LuisYonOfficial/Universal-Timing-Check-Device/Hardware/README.md

# Universal Timing Check Board (UTCB)
###### This repo acts as the digital storage of all associated developments (e.g. firmware, pcb development, CAD) and related documentation (e.g. schematic captures, pictures, testing data) to the "Universal Timing Check Board". This device acts as a sister companion to circuit testing for analog voltage checks and timing. Inspiration for board function and design is from previous revisions of an analog based brake system plausiblity device, however, this device is more general purpose and for my personal use. 

Image below shows a general esimate of how I intended the board to look like and inspired by (although to be at a much much smaller dimensional board footprint)



## Board Functionality
- Check if an upper threshold is met. (0v to 12v)
    - Multichannel Comparator check
- Check if a lower threshold is met.
    - Multichannel Comparator check (0v to 12v)
- Check if mid threshold comparison between 6 signals is met. 
    - Mid-threshold voltage set via 6 potentiometers (0v to 12v)
- Drive a failure mode signal out from either signals (12v, 7.5v, 3.3v, 0v)
- Have RGB LEDs that glow based on what failure condition per signal is failed or if there’s a net pass. These are tied to comparators? Might be tricky. 
    - Red: Threshold failure
    - Orange: Timing Failure
    - Green: No Failure
- Has breakout OLED slot for visualizing data in real time with bluetooth connected transmitter. Most likely will use STM32 for MCU. 
    
## Board Connection Points

Main PWR: 
- Optional 12V Power In Connector (Expands to 12v and 7.5v option for logic) 
- Main 5V Power In connector (Sets 5v and 3.3c logic)
- Final PWR voltage needs to be regulated (Off the shelf chip) 

Signal Connections (For reading)
- Terminal block connection points (4P header) for direct wire feeds. 
- For signal voltage reading: Has ribbon cable attachment to breadboard for data collection (but no direct programmable element on-board). 
- For board debugging: Set test points to grip onto for PWR points, Comparator Outputs, and final failure outputs. 
- Indivdual signals, logic set positions, threshold voltages are passed through to the data collection slot for telemetry. 

## Purpose

- Allows me to isolate analog logic voltages on an offboard device or PCB. 
- Allows me to clearly indicate where faulty logic is based on physical tuning via potentiometers. 
- Gives me an automated way of doing logic checks over set number of iterations on the device under test. 

## What to do next
- Finish basic logic check circuitry for 6 signals.
- Need to find a comparator chipset rated for 12v and higher. 
- Develop basic logic switch circuitry for determining if 3.3v, 5v, 7.5v, or 12v is being utilized for logic.
