LuisYonOfficial/Universal-Timing-Check-Device/Hardware/AddedFootprints/3D_Only/song-huei-r0904n-bxxx-l-20kq-by-thonk-1.snapshot.9/Thonk.jpg

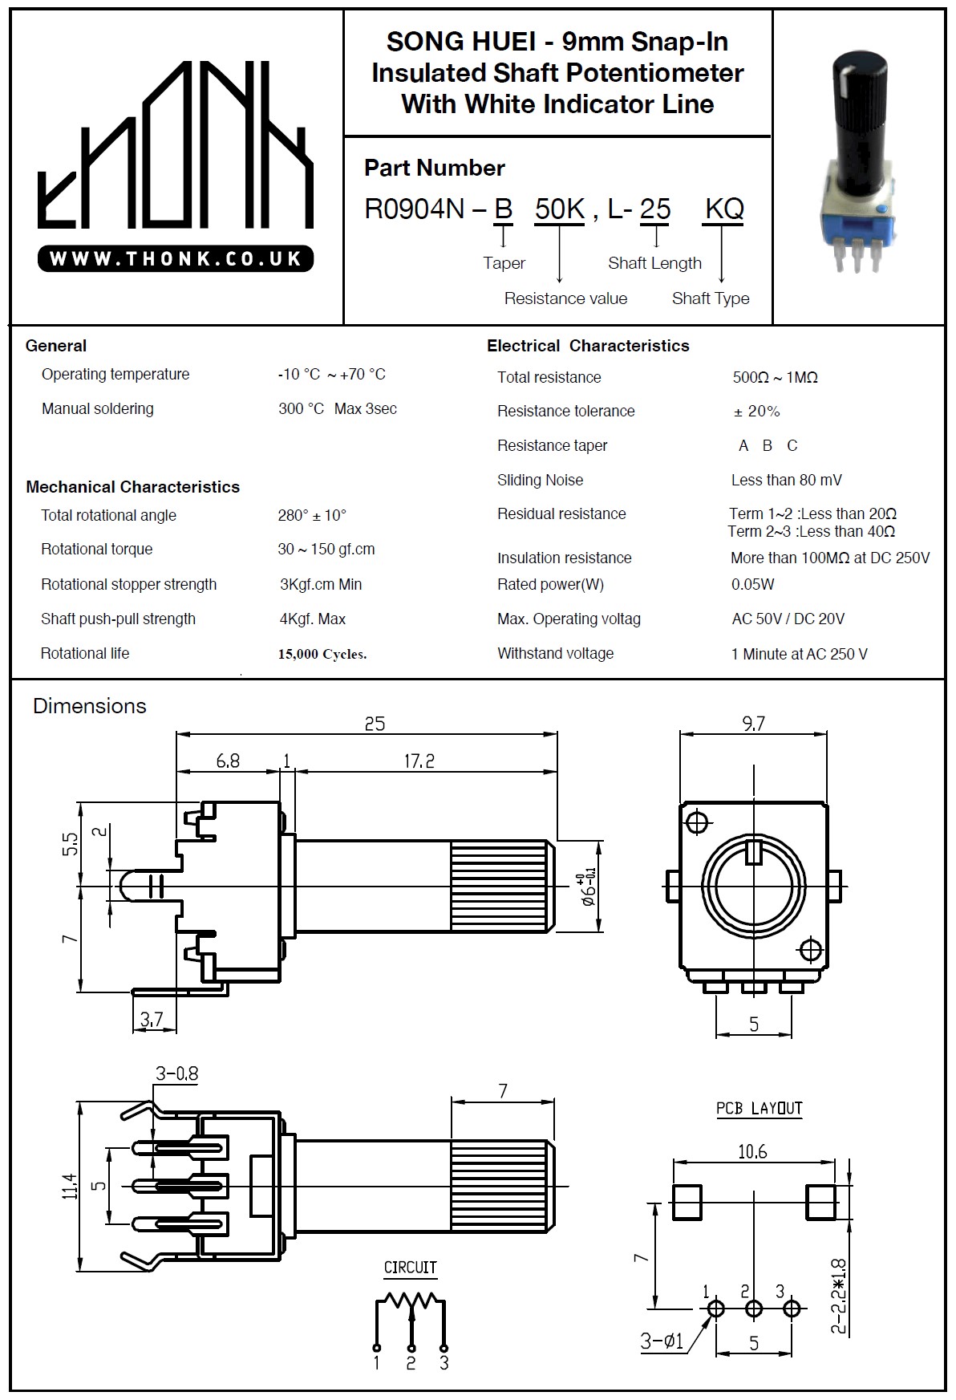
Hardware/AddedFootprints/3D_Only/song-huei-r0904n-bxxx-l-20kq-by-thonk-1.snapshot.9/Thonk.jpg
