LuisYonOfficial/Universal-Timing-Check-Device/Hardware/AddedFootprints/3D_Only/song-huei-r0904n-bxxx-l-20kq-by-thonk-1.snapshot.9/stp/R0904N-L-20KQ.stp

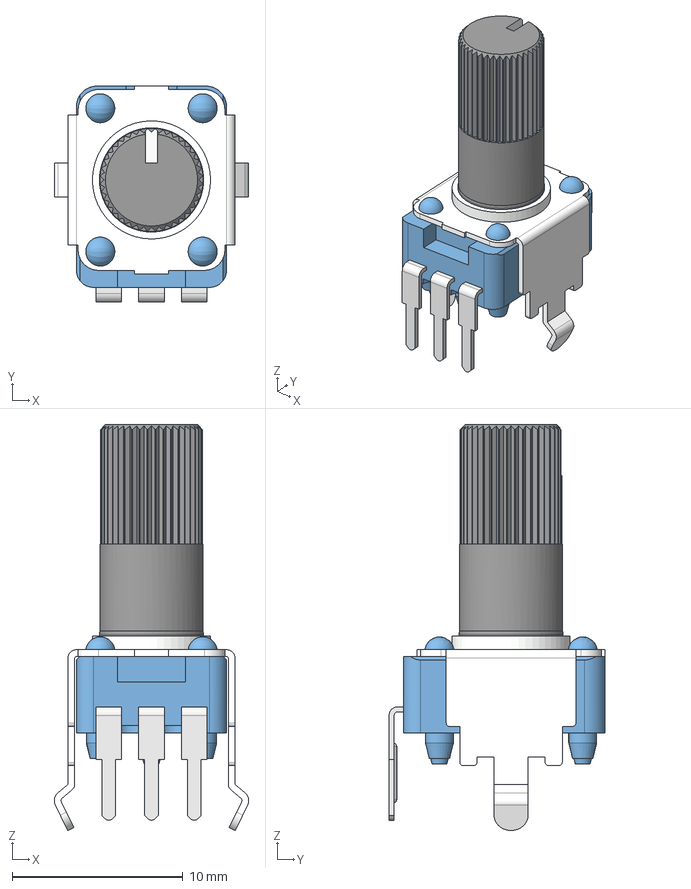
[picture p4: CAD file, 2023-03-07]
Hardware/AddedFootprints/3D_Only/song-huei-r0904n-bxxx-l-20kq-by-thonk-1.snapshot.9/stp/R0904N-L-20KQ.stp
11.4 x 12.7 x 23.8 mm
