LuisYonOfficial/Universal-Timing-Check-Device/Hardware/AddedFootprints/LIB_2SB1707TL/2SB1707TL/3D/2SB1707TL.stp

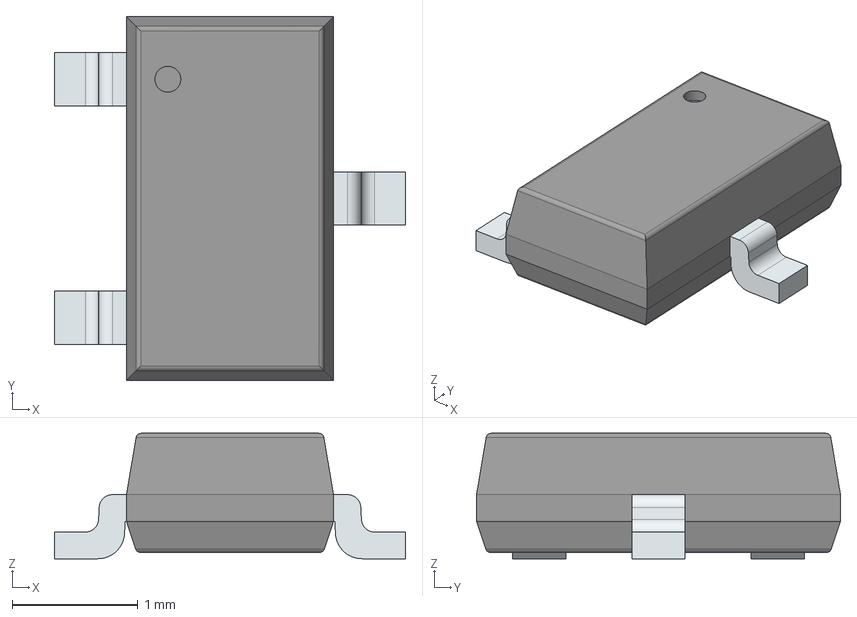
[picture p6: CAD file, 2023-03-03]
Hardware/AddedFootprints/LIB_2SB1707TL/2SB1707TL/3D/2SB1707TL.stp
2.80 x 2.90 x 1.00 mm
PinsArrayL
FilletPinR
