LuisYonOfficial/Universal-Timing-Check-Device/Hardware/AddedFootprints/LIB_2SD2653KT146/2SD2653KT146/3D/2SD2653KT146.stp

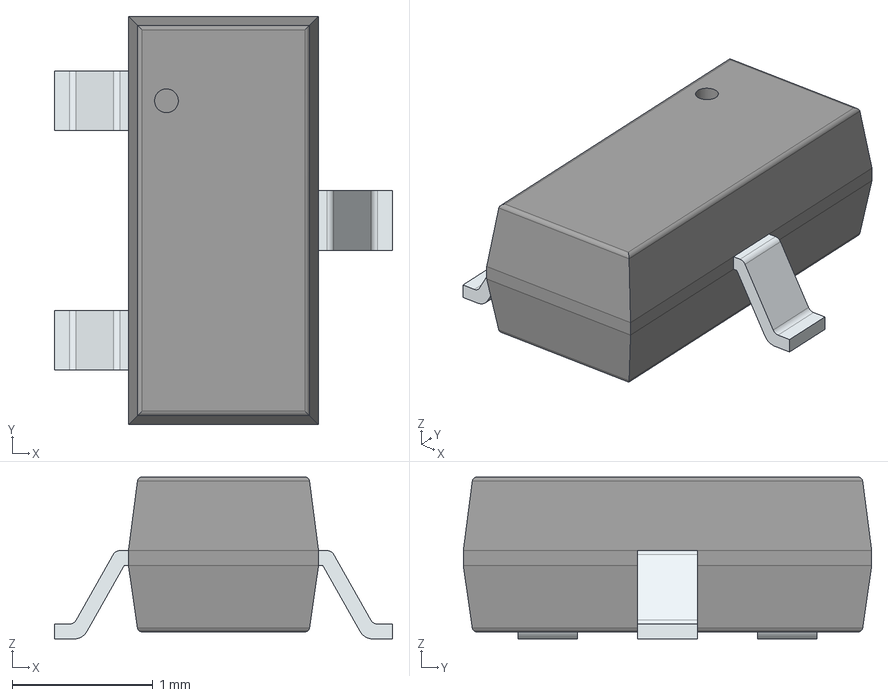
[picture p7: CAD file, 2023-03-03]
Hardware/AddedFootprints/LIB_2SD2653KT146/2SD2653KT146/3D/2SD2653KT146.stp
2.40 x 2.90 x 1.15 mm
PinsArrayL
FilletPinR
