LuisYonOfficial/Universal-Timing-Check-Device/Hardware/AddedFootprints/LIB_3557-2/3557-2/3D/3557-2.stp

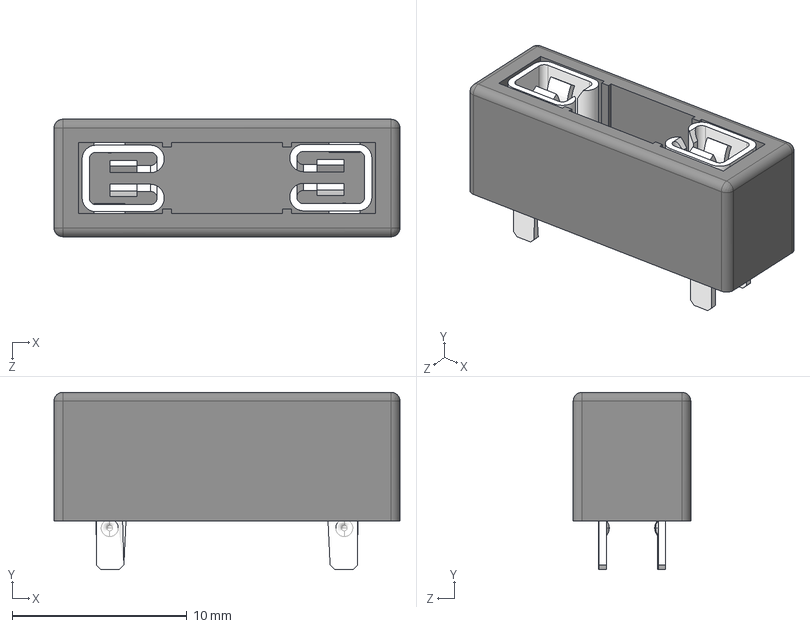
[picture p8: CAD file, 2023-03-03]
Hardware/AddedFootprints/LIB_3557-2/3557-2/3D/3557-2.stp
19.8 x 10.2 x 6.73 mm
