LuisYonOfficial/Universal-Timing-Check-Device/Hardware/AddedFootprints/LIB_BZT52H-A3V3-QX/BZT52H-A3V3-QX/3D/BZT52H-A3V3-QX.stp

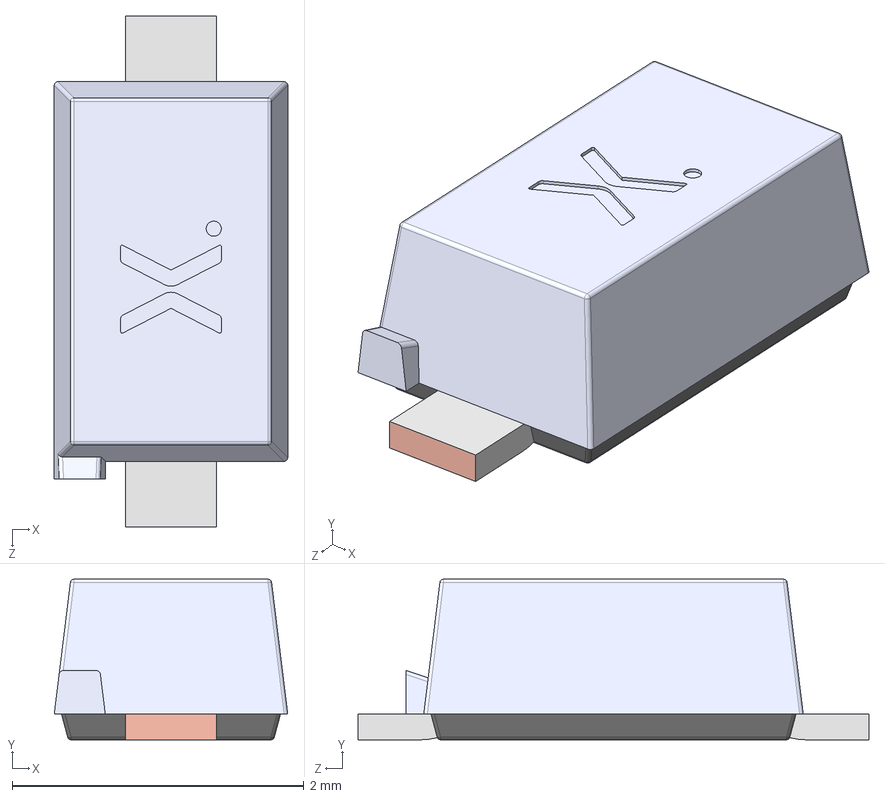
[picture p9: CAD file, 2023-03-03]
Hardware/AddedFootprints/LIB_BZT52H-A3V3-QX/BZT52H-A3V3-QX/3D/BZT52H-A3V3-QX.stp
1.60 x 1.10 x 3.50 mm
SOD123F Lead
SOD123F lower body
SOD123F upper body
