LuisYonOfficial/Universal-Timing-Check-Device/Hardware/AddedFootprints/LIB_MM3Z12VT1GX/MM3Z12VT1GX/3D/MM3Z12VT1GX.stp

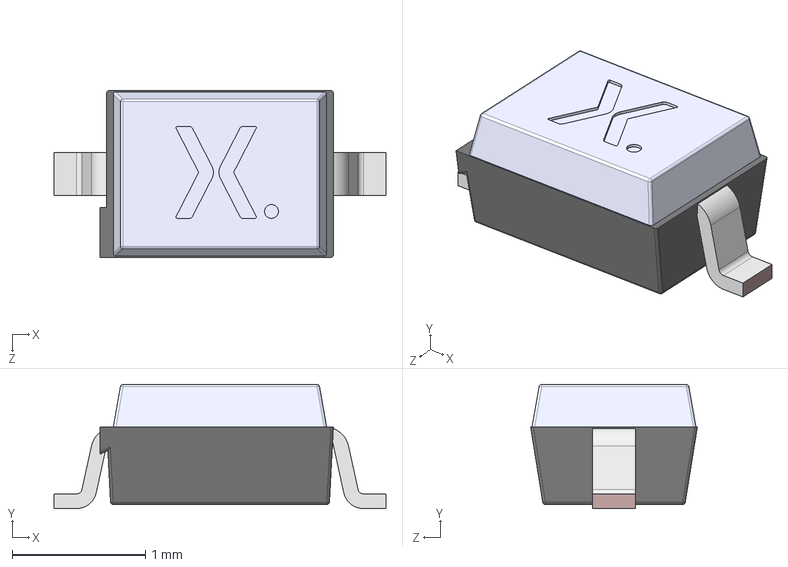
[picture p10: CAD file, 2023-03-03]
Hardware/AddedFootprints/LIB_MM3Z12VT1GX/MM3Z12VT1GX/3D/MM3Z12VT1GX.stp
2.49 x 0.93 x 1.25 mm
SOD323 Lower body
SOD323 Lead x 2
SOD323 Upper body
