LuisYonOfficial/Universal-Timing-Check-Device/Hardware/AddedFootprints/LIB_PTZTFTE257.5B/PTZTFTE257.5B/3D/PTZTFTE257.5B.stp

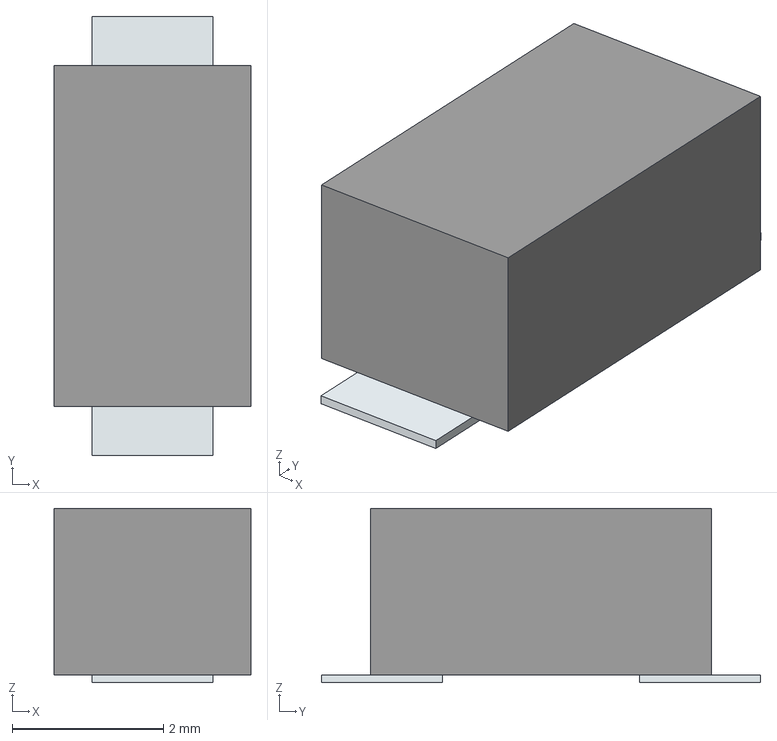
[picture p11: CAD file, 2023-03-03]
Hardware/AddedFootprints/LIB_PTZTFTE257.5B/PTZTFTE257.5B/3D/PTZTFTE257.5B.stp
2.60 x 5.80 x 2.30 mm
Pins
