LuisYonOfficial/Universal-Timing-Check-Device/Hardware/AddedFootprints/LIB_QSX7TR/QSX7TR/3D/QSX7TR.stp

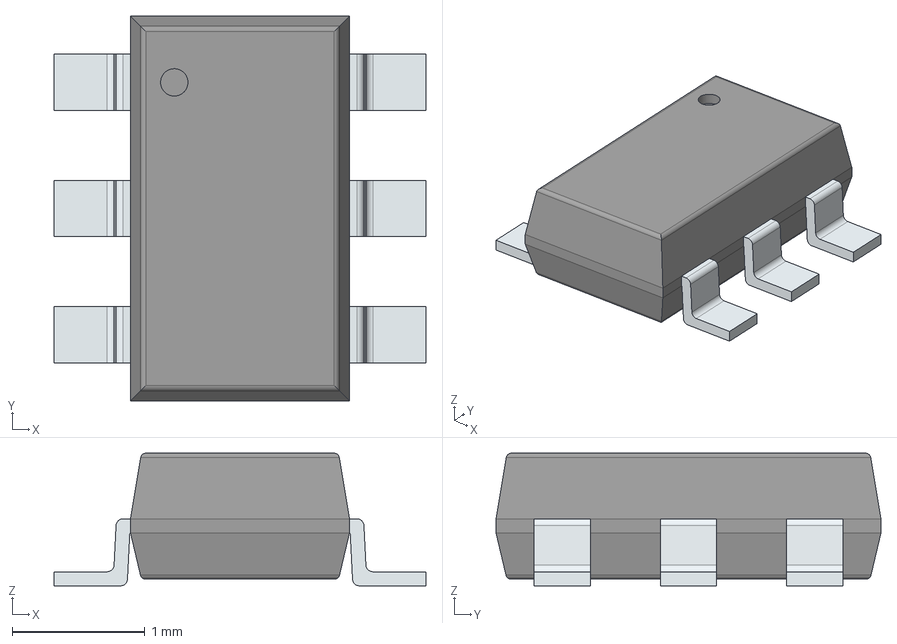
[picture p12: CAD file, 2023-03-03]
Hardware/AddedFootprints/LIB_QSX7TR/QSX7TR/3D/QSX7TR.stp
2.80 x 2.90 x 1.00 mm
PinsArrayLR
