LuisYonOfficial/Universal-Timing-Check-Device/Hardware/AddedFootprints/LIB_UDZVTE-174.7B/UDZVTE-174.7B/3D/UDZVTE-174.7B.stp

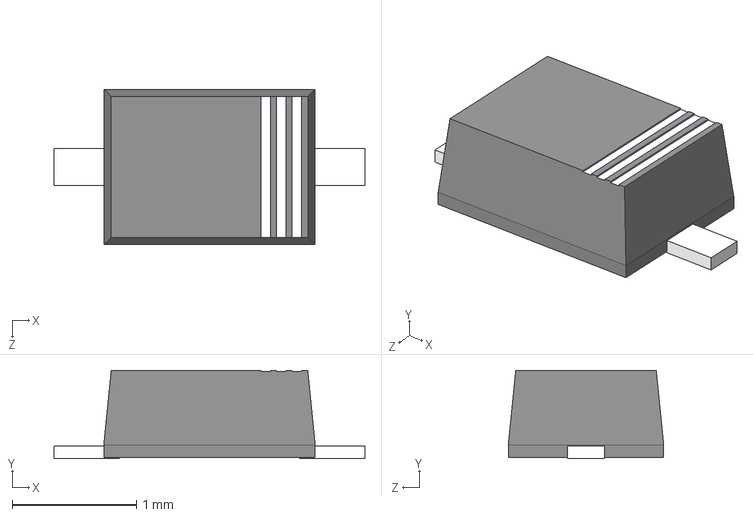
[picture p13: CAD file, 2023-03-03]
Hardware/AddedFootprints/LIB_UDZVTE-174.7B/UDZVTE-174.7B/3D/UDZVTE-174.7B.stp
2.50 x 0.71 x 1.25 mm
