LuisYonOfficial/Universal-Timing-Check-Device/Hardware/AddedFootprints/LIB_VXO7805-500-M-TR/VXO7805-500-M-TR/3D/VXO7805-500-M-TR.stp

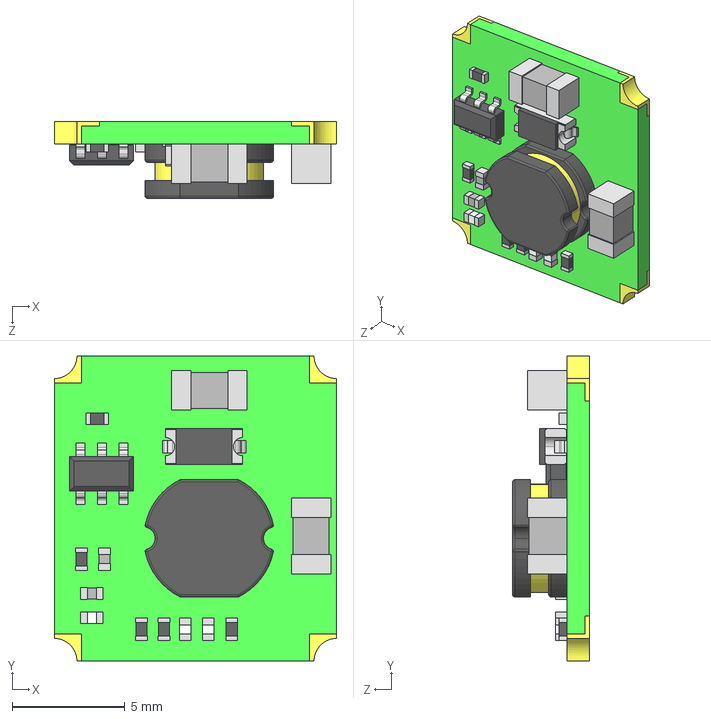
[picture p14: CAD file, 2023-03-03]
Hardware/AddedFootprints/LIB_VXO7805-500-M-TR/VXO7805-500-M-TR/3D/VXO7805-500-M-TR.stp
12.5 x 13.5 x 3.40 mm
