LuisYonOfficial/Universal-Timing-Check-Device/Hardware/AddedFootprints/test-points-smd-1.snapshot.1/RCU (0603).stp

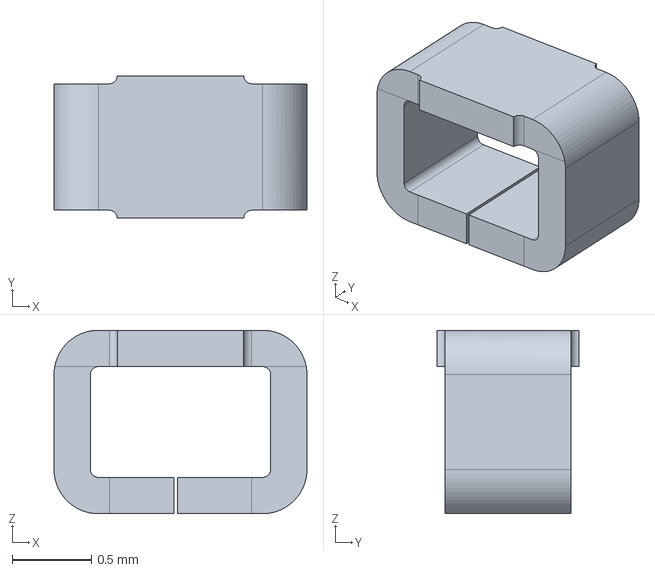
[picture p15: CAD file, 2023-04-03]
Hardware/AddedFootprints/test-points-smd-1.snapshot.1/RCU (0603).stp
1.60 x 0.9 x 1.16 mm
