LuisYonOfficial/Universal-Timing-Check-Device/Hardware/AddedFootprints/test-points-smd-1.snapshot.1/RCS (1206).stp

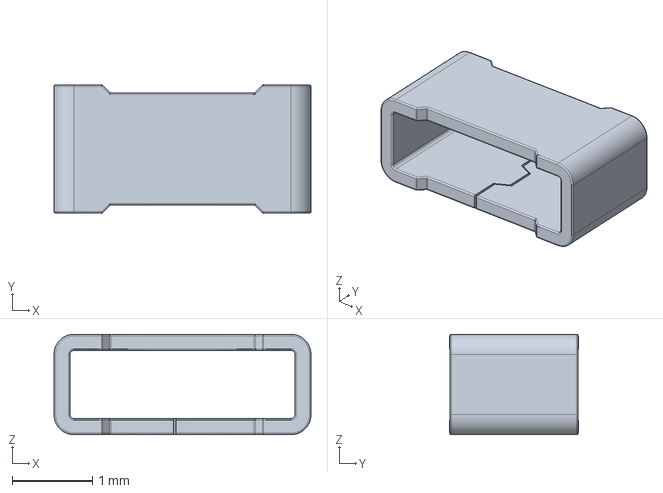
[picture p20: CAD file, 2023-04-03]
Hardware/AddedFootprints/test-points-smd-1.snapshot.1/RCS (1206).stp
3.20 x 1.60 x 1.25 mm
