LuisYonOfficial/Universal-Timing-Check-Device/Hardware/AddedFootprints/test-points-smd-1.snapshot.1/RCT (0805).stp

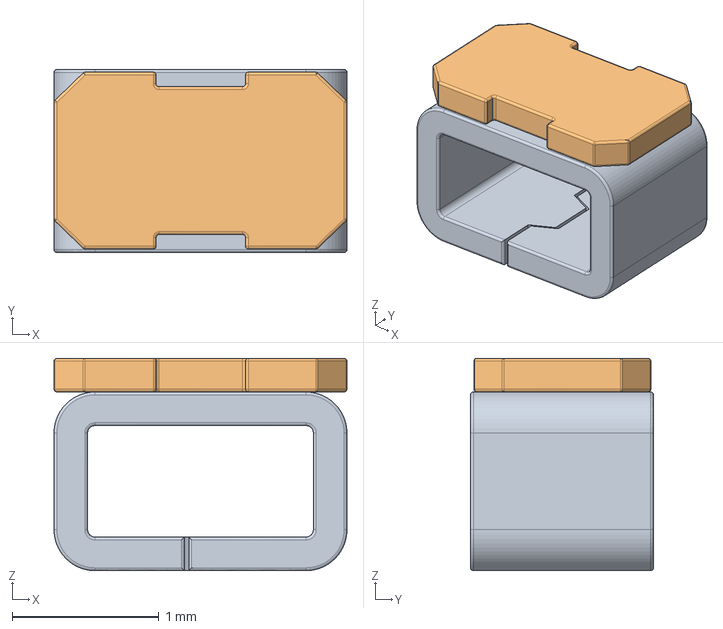
[picture p22: CAD file, 2023-04-03]
Hardware/AddedFootprints/test-points-smd-1.snapshot.1/RCT (0805).stp
2.00 x 1.25 x 1.45 mm
