LuisYonOfficial/Universal-Timing-Check-Device/Hardware/AddedFootprints/dip-switch-collection-1.snapshot.4/DS1040 (DIP-switch)/DS1040-09 (DIP_switch).stp

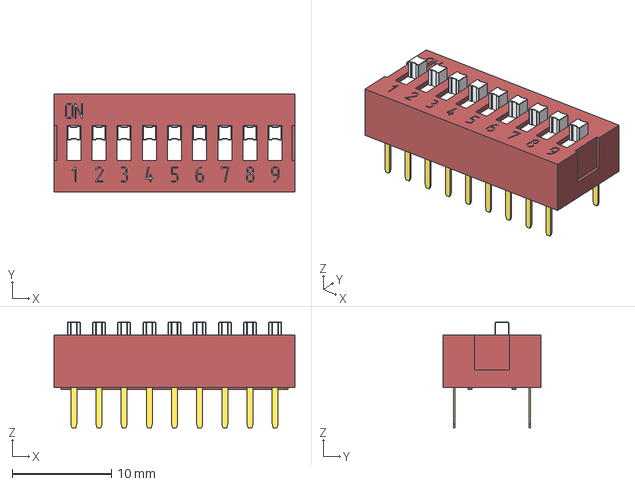
[picture p23: CAD file, 2023-03-23]
Hardware/AddedFootprints/dip-switch-collection-1.snapshot.4/DS1040 (DIP-switch)/DS1040-09 (DIP_switch).stp
24.3 x 9.90 x 10.7 mm
