LuisYonOfficial/Universal-Timing-Check-Device/(list of files, cad)

Other CAD files:
Hardware/AddedFootprints/LIB_173950536/173950536.stp
Hardware/AddedFootprints/LIB_2SB1707TL/2SB1707TL/Allegro/sot95p280x100-3n.psm
Hardware/AddedFootprints/LIB_2SB1707TL/2SB1707TL/DEHDL/2sb1707tl/chips/chips.prt
Hardware/AddedFootprints/LIB_2SD2653KT146/2SD2653KT146/Allegro/sot85p240x115-3n.psm
Hardware/AddedFootprints/LIB_2SD2653KT146/2SD2653KT146/DEHDL/2sd2653kt146/chips/chips.prt
Hardware/AddedFootprints/LIB_3557-2/3557-2/Allegro/3557-2.psm
Hardware/AddedFootprints/LIB_3557-2/3557-2/DEHDL/3557_2/chips/chips.prt
Hardware/AddedFootprints/LIB_418117270906/418117270906/3D/418117270906.stp
Hardware/AddedFootprints/LIB_418117270906/418117270906/Allegro/418117270906.psm
Hardware/AddedFootprints/LIB_418117270906/418117270906/DEHDL/418117270906/chips/chips.prt
Hardware/AddedFootprints/LIB_BZT52H-A3V3-QX/BZT52H-A3V3-QX/Allegro/sodfl3516x120n.psm
Hardware/AddedFootprints/LIB_BZT52H-A3V3-QX/BZT52H-A3V3-QX/DEHDL/bzt52h_a3v3_qx/chips/chips.prt
Hardware/AddedFootprints/LIB_MM3Z12VT1GX/MM3Z12VT1GX/Allegro/sod2512x110n.psm
Hardware/AddedFootprints/LIB_MM3Z12VT1GX/MM3Z12VT1GX/DEHDL/mm3z12vt1gx/chips/chips.prt
Hardware/AddedFootprints/LIB_NR01105ANG13-2C/NR01105ANG13-2C/3D/NR01105ANG13-2C.stp
Hardware/AddedFootprints/LIB_NR01105ANG13-2C/NR01105ANG13-2C/Allegro/nr01105ang132c.psm
Hardware/AddedFootprints/LIB_NR01105ANG13-2C/NR01105ANG13-2C/DEHDL/nr01105ang13_2c/chips/chips.prt
Hardware/AddedFootprints/LIB_PTZTFTE257.5B/PTZTFTE257.5B/Allegro/ptztfte2575b.psm
Hardware/AddedFootprints/LIB_PTZTFTE257.5B/PTZTFTE257.5B/DEHDL/ptztfte257.5b/chips/chips.prt
Hardware/AddedFootprints/LIB_QSX7TR/QSX7TR/Allegro/sot95p280x100-6n.psm
Hardware/AddedFootprints/LIB_QSX7TR/QSX7TR/DEHDL/qsx7tr/chips/chips.prt
Hardware/AddedFootprints/LIB_UDZVTE-174.7B/UDZVTE-174.7B/Allegro/udzvte1722b.psm
Hardware/AddedFootprints/LIB_UDZVTE-174.7B/UDZVTE-174.7B/DEHDL/udzvte_174.7b/chips/chips.prt
Hardware/AddedFootprints/LIB_VXO7805-500-M-TR/VXO7805-500-M-TR/Allegro/vxo7805500mtr.psm
Hardware/AddedFootprints/LIB_VXO7805-500-M-TR/VXO7805-500-M-TR/DEHDL/vxo7805_500_m_tr/chips/chips.prt
Hardware/AddedFootprints/test-points-smd-1.snapshot.1/RCS (1206).igs
Hardware/AddedFootprints/test-points-smd-1.snapshot.1/RCT (0805).igs
Hardware/AddedFootprints/test-points-smd-1.snapshot.1/RCU (0603).igs
Hardware/AddedFootprints/test-points-smd-1.snapshot.1/RCW (1206).igs
