LuisYonOfficial/Universal-Timing-Check-Device/Hardware/AddedFootprints/test-points-smd-1.snapshot.1/test points SMD.jpg

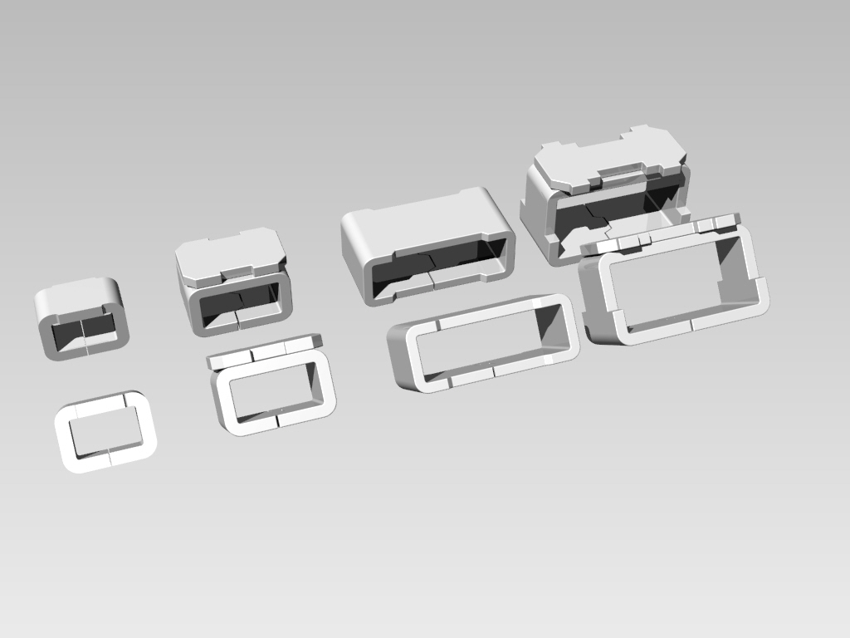
Hardware/AddedFootprints/test-points-smd-1.snapshot.1/test points SMD.jpg
