LuisYonOfficial/Universal-Timing-Check-Device/Hardware/AddedFootprints/hazard.png

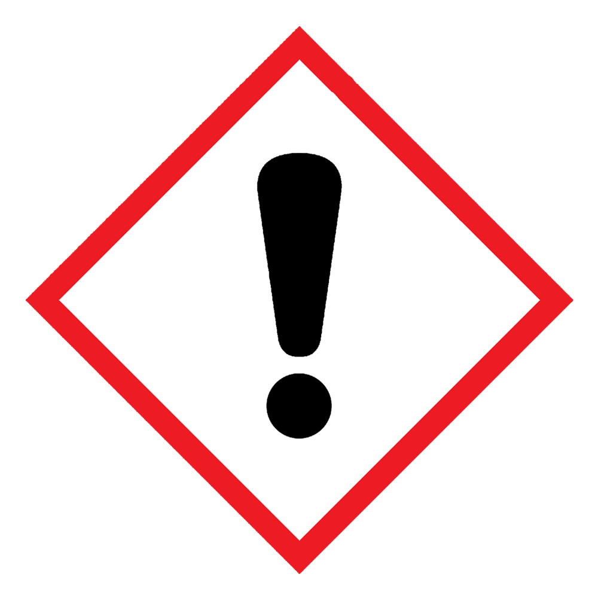
Hardware/AddedFootprints/hazard.png
