LuisYonOfficial/Universal-Timing-Check-Device/(list of files, drawings)

Other design files:
Hardware/AddedFootprints/LIB_2SB1707TL/2SB1707TL/Altium/2SB1707TL.SchLib
Hardware/AddedFootprints/LIB_2SB1707TL/2SB1707TL/Altium/SOT95P280X100-3N.PcbLib
Hardware/AddedFootprints/LIB_2SD2653KT146/2SD2653KT146/Altium/2SD2653KT146.SchLib
Hardware/AddedFootprints/LIB_2SD2653KT146/2SD2653KT146/Altium/SOT85P240X115-3N.PcbLib
Hardware/AddedFootprints/LIB_3557-2/3557-2/Altium/3557-2.PcbLib
Hardware/AddedFootprints/LIB_3557-2/3557-2/Altium/3557-2.SchLib
Hardware/AddedFootprints/LIB_418117270906/418117270906/Altium/418117270906.PcbLib
Hardware/AddedFootprints/LIB_418117270906/418117270906/Altium/418117270906.SchLib
Hardware/AddedFootprints/LIB_BZT52H-A3V3-QX/BZT52H-A3V3-QX/Altium/BZT52H-A3V3-QX.SchLib
Hardware/AddedFootprints/LIB_BZT52H-A3V3-QX/BZT52H-A3V3-QX/Altium/SODFL3516X120N.PcbLib
Hardware/AddedFootprints/LIB_MM3Z12VT1GX/MM3Z12VT1GX/Altium/MM3Z12VT1GX.SchLib
Hardware/AddedFootprints/LIB_MM3Z12VT1GX/MM3Z12VT1GX/Altium/SOD2512X110N.PcbLib
Hardware/AddedFootprints/LIB_NR01105ANG13-2C/NR01105ANG13-2C/Altium/NR01105ANG13-2C.SchLib
Hardware/AddedFootprints/LIB_NR01105ANG13-2C/NR01105ANG13-2C/Altium/NR01105ANG132C.PcbLib
Hardware/AddedFootprints/LIB_PTZTFTE257.5B/PTZTFTE257.5B/Altium/PTZTFTE257.5B.SchLib
Hardware/AddedFootprints/LIB_PTZTFTE257.5B/PTZTFTE257.5B/Altium/PTZTFTE2575B.PcbLib
Hardware/AddedFootprints/LIB_QSX7TR/QSX7TR/Altium/QSX7TR.SchLib
Hardware/AddedFootprints/LIB_QSX7TR/QSX7TR/Altium/SOT95P280X100-6N.PcbLib
Hardware/AddedFootprints/LIB_UDZVTE-174.7B/UDZVTE-174.7B/Altium/UDZVTE1722B.PcbLib
Hardware/AddedFootprints/LIB_UDZVTE-174.7B/UDZVTE-174.7B/Altium/UDZVTE-174.7B.SchLib
Hardware/AddedFootprints/LIB_VXO7805-500-M-TR/VXO7805-500-M-TR/Altium/VXO7805-500-M-TR.SchLib
Hardware/AddedFootprints/LIB_VXO7805-500-M-TR/VXO7805-500-M-TR/Altium/VXO7805500MTR.PcbLib
