LuisYonOfficial/Universal-Timing-Check-Device/Hardware/UTCB.kicad_pcb

## KiCad design Hardware/UTCB.kicad_pcb (2023-04-03)

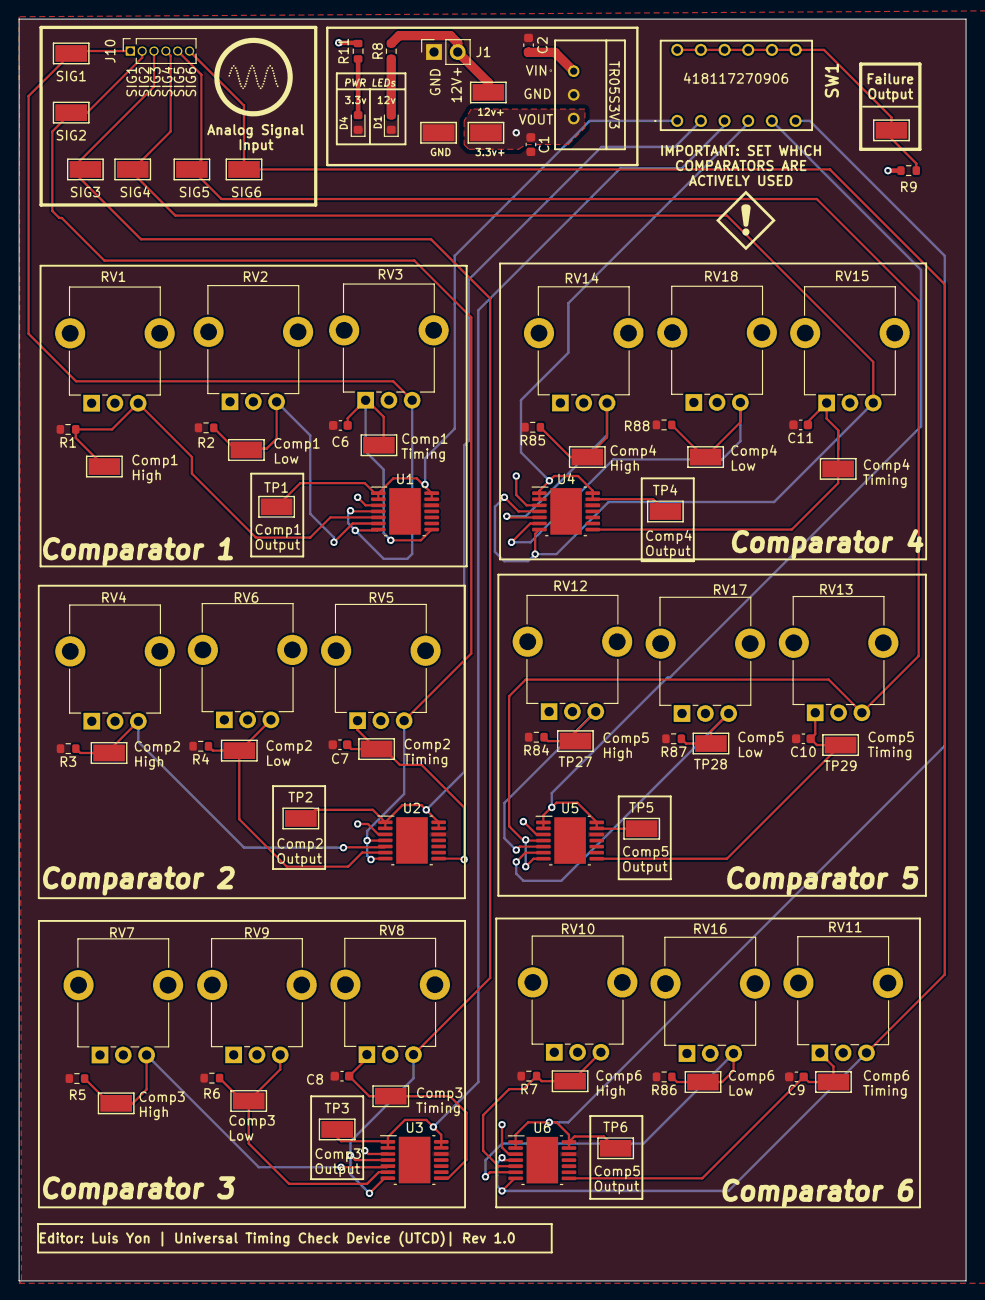
[picture p33: board UTCB.kicad_pcb from above]

Board: 4 copper layers, 101.6 x 135.4 mm, 87 parts (0 on the bottom side), 36 nets.

Parts:
C1: 47uF; C_0603_1608Metric
C2: 22uF; C_0603_1608Metric
C6, C7, C8, C9, C10, C11: 10uF; C_0603_1608Metric
D1: APT1608SEC/J3-AMT; D_0603_1608Metric
D4: SMLEN3WBC8W1; D_0603_1608Metric
IC1: TR05S3V3
J1: Conn_01x02; PinSocket_1x02_P2.54mm_Vertical
J10: Conn_01x06; PinSocket_1x06_P1.27mm_Vertical
R1, R2, R3, R4, R5, R6, R7, R84, R85, R86, R87, R88: 10kΩ; R_0603_1608Metric
R8, R11: R_Small; R_0603_1608Metric
R9: 1k; R_0603_1608Metric
RV1, RV2, RV4, RV6, RV7, RV9, RV10, RV12, RV14, RV16, RV17, RV18: R_Potentiometer_Trim; Potentiometer_Alpha_RD901F-40-00D_Single_Vertical_CircularH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
RV3, RV5, RV8, RV11, RV13, RV15: 10kΩ; Potentiometer_Alpha_RD901F-40-00D_Single_Vertical_CircularH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
SW1: SW_DIP_x06; 418117270906
TP1: Comp1_Output; TestPoint_Keystone_5015_Micro-Minature
TP2: Comp2_Output; TestPoint_Keystone_5015_Micro-Minature
TP3: Comp3_Output; TestPoint_Keystone_5015_Micro-Minature
TP4: Comp4_Output; TestPoint_Keystone_5015_Micro-Minature
TP5: Comp5_Output; TestPoint_Keystone_5015_Micro-Minature
TP6: Comp6_Output; TestPoint_Keystone_5015_Micro-Minature
TP7: COMP1_HIGH; TestPoint_Keystone_5015_Micro-Minature
TP8: COMP1_LOW; TestPoint_Keystone_5015_Micro-Minature
TP9: COMP1_TIMING; TestPoint_Keystone_5015_Micro-Minature
TP10: COMP2_HIGH; TestPoint_Keystone_5015_Micro-Minature
TP11: COMP2_LOW; TestPoint_Keystone_5015_Micro-Minature
TP12: COMP2_TIMING; TestPoint_Keystone_5015_Micro-Minature
TP13: 12v_Check; TestPoint_Keystone_5015_Micro-Minature
TP14, TP15: COMP3_HIGH; TestPoint_Keystone_5015_Micro-Minature
TP16: 3.3v_Check; TestPoint_Keystone_5015_Micro-Minature
TP17: Signal1_Check; TestPoint_Keystone_5015_Micro-Minature
TP18: Signal2_Check; TestPoint_Keystone_5015_Micro-Minature
TP19: Signal3_Check; TestPoint_Keystone_5015_Micro-Minature
TP20: Signal4_Check; TestPoint_Keystone_5015_Micro-Minature
TP21: Signal5_Check; TestPoint_Keystone_5015_Micro-Minature
TP22: Signal6_Check; TestPoint_Keystone_5015_Micro-Minature
TP23, TP29: COMP3_TIMING; TestPoint_Keystone_5015_Micro-Minature
TP24, TP25: COMP4_HIGH; TestPoint_Keystone_5015_Micro-Minature
TP26: COMP4_TIMING; TestPoint_Keystone_5015_Micro-Minature
TP27, TP28: COMP5_HIGH; TestPoint_Keystone_5015_Micro-Minature
TP30, TP31: COMP6_HIGH; TestPoint_Keystone_5015_Micro-Minature
TP32: COMP6_TIMING; TestPoint_Keystone_5015_Micro-Minature
TP33: Failure_Check; TestPoint_Keystone_5015_Micro-Minature
TP34: GND_Check; TestPoint_Keystone_5015_Micro-Minature
U1, U2, U3, U4, U5, U6: HTSSOP-14-1EP_4.4x5mm_P0.65mm_EP3.4x5mm_Mask3x3.1mm

Connections:
+3.3V: C1.1, IC1.3 (+VOUT), R9.1, R11.1, RV1.1, RV2.1, RV4.1, RV6.1, RV7.1, RV9.1, RV10.1, RV12.1, RV14.1, RV16.1, RV17.1, RV18.1, TP16.1, U1.3 (VCC), U2.3 (VCC), U3.3 (VCC), U4.3 (VCC), U5.3 (VCC), U6.3 (VCC)
+12V: C2.1, IC1.1 (+VIN), J1.2, R8.2, TP13.1
/ComparatorLogic/COMP1_HIGH: R1.1, RV1.3, TP7.1, U1.5 (1IN+)
/ComparatorLogic/COMP1_LOW: R2.1, RV2.3, TP8.1, U1.6 (2IN-)
/ComparatorLogic/COMP2_HIGH: R3.1, RV4.3, TP10.1, U2.5 (1IN+)
/ComparatorLogic/COMP2_LOW: R4.1, RV6.3, TP11.1, U2.6 (2IN-)
/ComparatorLogic/COMP3_HIGH: R5.1, RV7.3, TP14.1, U3.5 (1IN+)
/ComparatorLogic/COMP3_LOW: R6.1, RV9.3, TP15.1, U3.6 (2IN-)
/ComparatorLogic/COMP4_HIGH: R85.1, RV14.3, TP24.1, U4.5 (1IN+)
/ComparatorLogic/COMP4_LOW: R88.1, RV18.3, TP25.1, U4.6 (2IN-)
/ComparatorLogic/COMP5_HIGH: R84.1, RV12.3, TP27.1, U5.5 (1IN+)
/ComparatorLogic/COMP5_LOW: R87.1, RV17.3, TP28.1, U5.6 (2IN-)
/ComparatorLogic/COMP6_HIGH: R7.1, RV10.3, TP30.1, U6.5 (1IN+)
/ComparatorLogic/COMP6_LOW: R86.1, RV16.3, TP31.1, U6.6 (2IN-)
/ComparatorLogic/Failure_Output: R9.2, SW1.7, SW1.8, SW1.9, SW1.10, SW1.11, SW1.12, TP33.1
/ComparatorLogic/Timing1Check: C6.1, RV3.1, TP9.1, U1.8 (3IN-)
/ComparatorLogic/Timing2Check: C7.1, RV5.1, TP12.1, U2.8 (3IN-)
/ComparatorLogic/Timing3Check: C8.1, RV8.1, TP23.1, U3.8 (3IN-)
/ComparatorLogic/Timing4Check: C11.1, RV15.1, TP26.1, U4.8 (3IN-)
/ComparatorLogic/Timing5Check: C10.1, RV13.1, TP29.1, U5.8 (3IN-)
/ComparatorLogic/Timing6Check: C9.1, RV11.1, TP32.1, U6.8 (3IN-)
COMP1A: SW1.1, TP1.1, U1.1 (2OUT), U1.2 (1OUT), U1.13 (4OUT), U1.14 (3OUT)
COMP2A: SW1.2, TP2.1, U2.1 (2OUT), U2.2 (1OUT), U2.13 (4OUT), U2.14 (3OUT)
COMP3A: SW1.3, TP3.1, U3.1 (2OUT), U3.2 (1OUT), U3.13 (4OUT), U3.14 (3OUT)
COMP4A: SW1.4, TP4.1, U4.1 (2OUT), U4.2 (1OUT), U4.13 (4OUT), U4.14 (3OUT)
COMP5A: SW1.5, TP5.1, U5.1 (2OUT), U5.2 (1OUT), U5.13 (4OUT), U5.14 (3OUT)
COMP6A: SW1.6, TP6.1, U6.1 (2OUT), U6.2 (1OUT), U6.13 (4OUT), U6.14 (3OUT)
GND: C1.2, C2.2, C6.2, C7.2, C8.2, C9.2, C10.2, C11.2, D1.1 (K), D4.1 (K), IC1.2 (GND), J1.1, R1.2, R2.2, R3.2, R4.2, R5.2, R6.2, R7.2, R84.2, R85.2, R86.2, R87.2, R88.2, TP34.1, U1.12 (VIN-), U2.12 (VIN-), U3.12 (VIN-), U4.12 (VIN-), U5.12 (VIN-), U6.12 (VIN-)
unnamed: D1.2 (A), R8.1
unnamed: D4.2 (A), R11.2
Signal1: J10.1, RV3.3, TP17.1, U1.4 (1IN-), U1.7 (2IN+)
Signal2: J10.2, RV5.3, TP18.1, U2.4 (1IN-), U2.7 (2IN+)
Signal3: J10.3, RV8.3, TP19.1, U3.4 (1IN-), U3.7 (2IN+)
Signal4: J10.4, RV15.3, TP20.1, U4.4 (1IN-), U4.7 (2IN+)
Signal5: J10.5, RV13.3, TP21.1, U5.4 (1IN-), U5.7 (2IN+)
Signal6: J10.6, RV11.3, TP22.1, U6.4 (1IN-), U6.7 (2IN+)
