LuisYonOfficial/Universal-Timing-Check-Device/(commit log)

2023-02-27 Update README.md
    added image for pseudo estimate of potentiometer and board layout
2023-02-27 Update README.md
    added programmable slot
2023-02-28 Added changes for initial logic comparisons
    [UTCB.kicad_pcb, UTCB.kicad_sch]
2023-02-28 Reorganized folders
    [UTCB.kicad_pcb, UTCB.kicad_sch]
2023-03-02 Added some changes for the logic switching circuitry. Will be adding thyristor or cascaded bjt configuration for various lighting types for each logic level
    [ComparatorLogic.kicad_sch, LogicSelector.kicad_sch, UTCB.kicad_sch, untitled.kicad_sch]
2023-03-03 Completed Logic Selector page with respec to rotary switches and LED tied to selected voltage levels
    [2SB1707TL.SchLib, 2SB1707TL.stp, 2SD2653KT146.SchLib, 2SD2653KT146.stp, BZT52H-A3V3-QX.SchLib, BZT52H-A3V3-QX.stp, ComparatorLogic.kicad_sch, EDI2CAP.CFG]
2023-03-03 Added 3D models
    [3557-2.PcbLib, 3557-2.SchLib, 3557-2.psm, 3557-2.stp, ComparatorLogic.kicad_sch, EDI2CAP.CFG, LogicSelector.kicad_sch, NR01105ANG13-2C.SchLib]
2023-03-07 Added updates to logic switches for timing based logic. Updated attached 3D models.
    [R0904N-L-20KQ.stp, R0904N-L-25KQ.stp, UTCB.kicad_pcb, UTCB.kicad_sch]
2023-03-07 Added updates to pcb file and timing logic
    [ComparatorLogic.kicad_sch]
2023-03-07 Added changes to logic timing
    [ComparatorLogic.kicad_sch, UTCB.kicad_pcb]
2023-03-22 Added changes to logic side for comparator inputs
    [ComparatorLogic.kicad_sch, LogicSelector.kicad_sch, StepDownPower.kicad_sch, UTCB.kicad_pcb, UTCB.kicad_sch]
2023-03-22 Removed a lot of unnecessary BJT logic, removed rotary switches for logic setting (set all to universal final 3.3v based logic)
    [ComparatorLogic.kicad_sch, StepDownPower.kicad_sch, UTCB.kicad_pcb, UTCB.kicad_sch]
2023-03-22 Update README.md
    Added mention of removing timing checks for certain logic stages
2023-03-23 Added dip switch for comparator active selection
    [418117270906.PcbLib, 418117270906.SchLib, 418117270906.psm, 418117270906.stp, ComparatorLogic.kicad_sch, DS1040-01 (DIP_switch).stp, DS1040-02 (DIP_switch).stp, DS1040-03 (DIP_switch).stp]
2023-03-23 Continued traces for layout
    [UTCB.kicad_pcb]
2023-03-26 Added additional trace routing
    [UTCB.kicad_pcb]
2023-03-26 Organized main sheet
    [ComparatorLogic.kicad_sch, UTCB.kicad_sch]
2023-03-27 Organized schematic outline
    Misc. changes to schematic.
    [ComparatorLogic.kicad_sch]
2023-04-03 Completed rev1.0 traces
    Finished traces
    [UTCB.kicad_pcb]
2023-04-03 Minor modifications
    Added 3D model for the regulator, updated to socket for signal inputs, and updated to power pours for certain PWR pins.
    [173950536.stp, ComparatorLogic.kicad_sch, RCS (1206).igs, RCS (1206).stp, RCT (0805).igs, RCT (0805).stp, RCU (0603).igs, RCU (0603).stp]
